handeyildirim/Analog-PCB-and-Schematic-Designing-Project/Ekran Alıntısı7.JPG

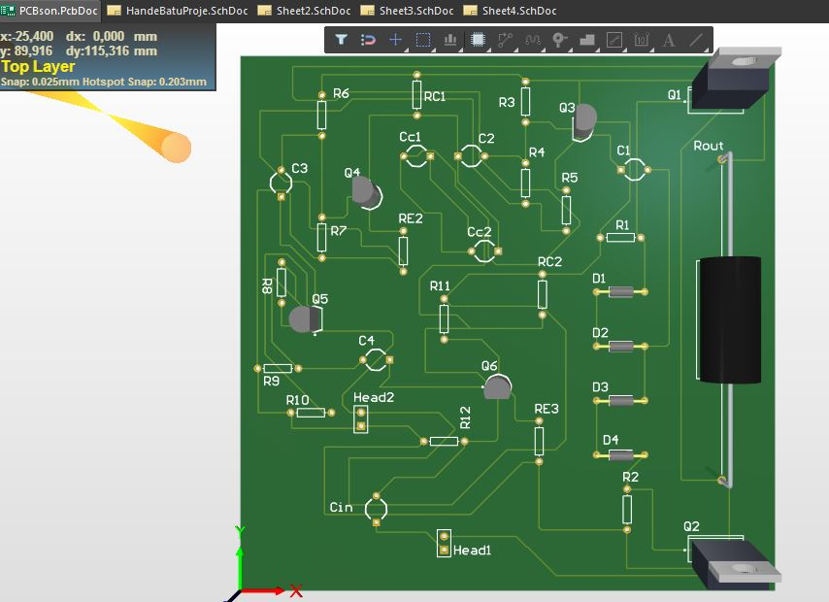
Ekran Alıntısı7.JPG
