handeyildirim/Analog-PCB-and-Schematic-Designing-Project/Ekran Alıntısı9.JPG

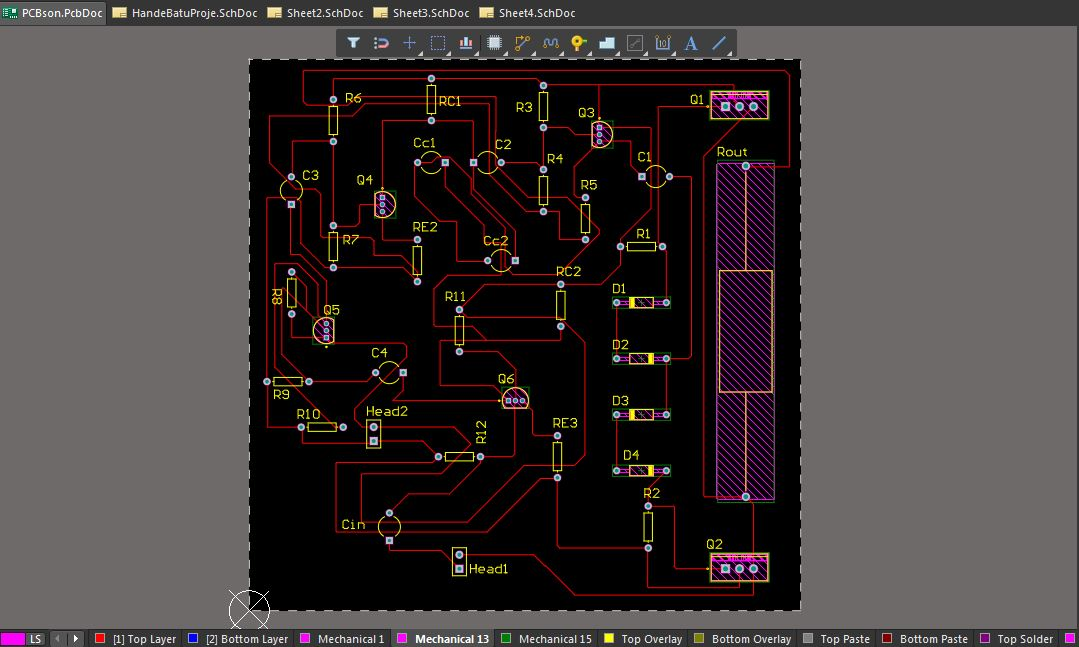
Ekran Alıntısı9.JPG
