handeyildirim/Analog-PCB-and-Schematic-Designing-Project/README.md

# Analog-PCB-and-Schematic-Designing-Project
To Design A 500 Voltage Gain And 20Hz-1MHz Threshold Frequency Range Speaker's Schematic and PCB
