handeyildirim/Analog-PCB-and-Schematic-Designing-Project/HandeYildirim_141201047_Rapor2.docx

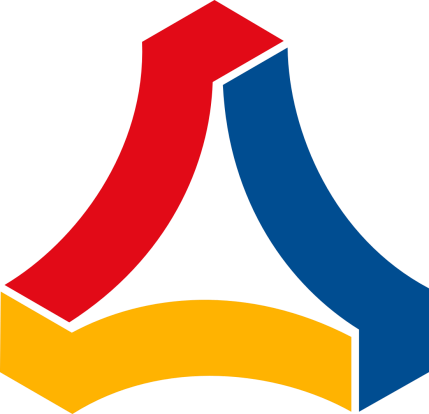
[picture p3: figure]

TOBB Ekonomi ve Teknoloji Üniversitesi

Elektrik – Elektronik Mühendisliği Bölümü

ELE311 – Analog Elektronik Devreler

## Proje Raporu - 2

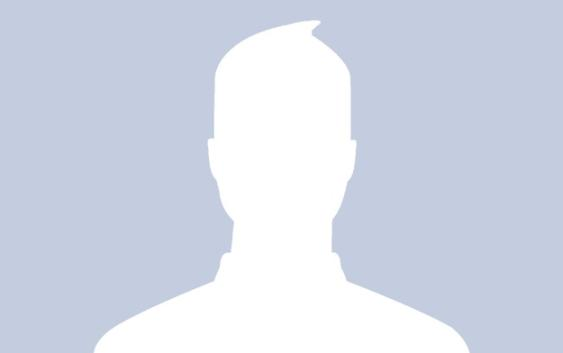
[picture p4: figure]

Adı Soyadı | Hande Yıldırım
Numara | 141201047
Tarih | 30.03.2020

1. GİRİŞ
  1.1. Projenin Amacı

Bu deneyde aşağıdaki özellikleri sağlayan bir yükseltici tasarlanması istenilmektedir:

a. Voltaj kazancı: 500

b. 8 Ω üzerine 5 W RMS güç verebilmek.

c. Eşik frekansları: 20 Hz – 1 MHz

Bu özellikleri sağlayan bir yükseltici çok katlı olacaktır. İlk rapor için 3 katman kullanılarak tasarım yapıldı, fakat daha sonrasında yapılan hesaplamalar sonucunda 4 katmanda daha iyi veriler elde edilerek tasarım yenilenmiştir.

  1.2. Projenin Faydaları

Bu proje yapılırken bir çok faydası olmuştur. Bunlar şu şekilde sıralanabilir:

- Altium, Eagle, Multisim, LT Spice gibi önemli tasarım programlarının kullanımı öğrenildi.
- Yükseltici analizlerinin yapımı anlaşıldı.
- Analog devreler ve çalışma mantıkları iyice öğrenildi.
2. PCB TASARIM SÜRECİ

Bu kısımda genel olarak PCB’nin tasarım süreci anlatılmıştır. PCB tasarımı yapmak için Altium programı kullanılmıştır. Sırasıyla yapılan işlemler şu şekildedirler:

1) Öncelikle simülasyon programında tasarlanmış olan devre Altium’da şematik olarak çizilmiştir. Bu yapılırken kullanılan her bir materyal Altium’un var olan kütüphanesinden olmayanlar da internetten kütüphaneleri indirilerek şematiğe eklenmişlerdir.
2) İndirme işlemi sonrası direnç, kapasitör, transistör gibi devre elemanları kolaylıkla devreye eklenmişlerdir ve aralarına line kullanılarak kablolama yapılmıştır.
3) Ayrıca her bir katman arasında rastgele delikler koyularak PCB basımı sonrası buraya kablolar lehimlenip her bir katmanın kolaylıkla ölçümünün yapılması sağlanmıştır.
4) AC ve DC kaynak girişleri için ise header kullanarak buralarda VCC, -VCC, GND, AC voltaj girişleri oluşturulmuşlardır.
5) Şematik çiziminde son olarak devre elemanlarının isimlendirmeleri tamamlanmıştır.
6) Şematik çizimi tamamlandıktan sonra PCB dosyası oluşturuldu ve PCB’nin ölçüleri şu şekilde ayarlandı:
i. PCB Boyutları: 10cm x 10cm
ii. Distance between conductors: 0.20mm
iii. Conductor width: 0.20mm
iv. Annular clearance PAD – Cu: 0.20mm
v. Copper PAD width: 0.80mm
vi. Drill width: 0.35mm
vii. VIA: 0.8mm – 0.9mm
7) Bu ayarlamalardan sonra şematikte yer alan devre PCB’ye aktarıldı.
8) PCB aktarımı sonrası devre karışık bir şekilde geldiğinden her bir malzemenin PCB üzerindeki konumları belirlendi.
9) Malzemelerin Hepsi PCB’nin Mechanical 13 katmanına yerleştirildi.
10) Sonrasında malzemeler arasındaki kabloların hiçbiri çakışmayacak şekilde tekrar kablolama büyük bir özenle yapıldı.
11) Daha sonra grup numaraları ve projeyi yapanların isimleri yazıldı.
12) En son devre bir kere daha hem 2D hem de 3D olacak şekilde kontrol edildi.
13) Kontroller bittikten sonra PCB’nin Bottom katmanına topraklama yapıldı ve PCB basımı için Gerber Dosyası oluşturuldu.

Tüm bu işlemlerin yapım aşamalarına göre şematiği Şekil 2.1’de ve en son elde edilmiş olan PCB’nin Şekil 2.2’deki gibi hem 2 boyutlu, hem de Şekil 2.3’teki gibi 3 boyutlu görselleri aşağıdaki gibidirler:

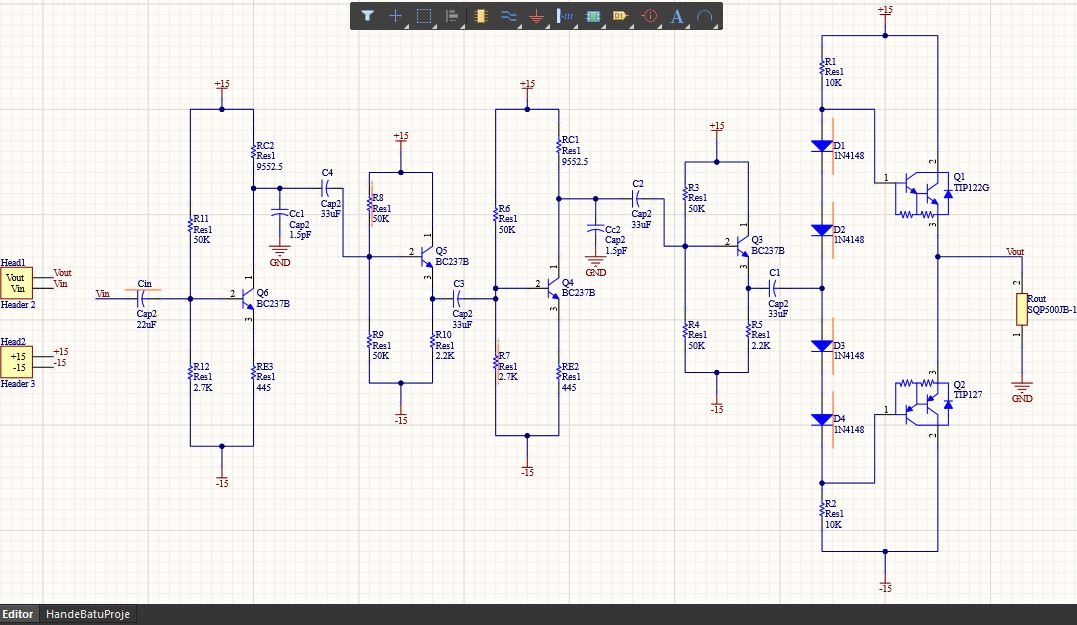
[picture p5: figure]

Şekil 2.1: Altium Programında Tüm Devrenin Şematiğinin Gösterimi

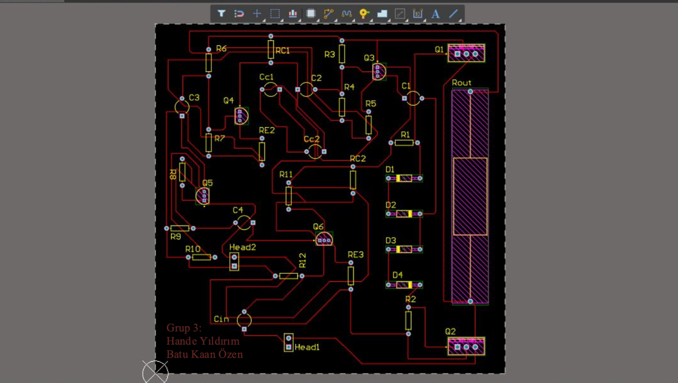
[picture p6: figure]

Şekil 2.1: Altium’da Şematikte Çizilmiş Olan Devrenin PCB’ye aktarılmış 2 Boyutlu Görüntüsü

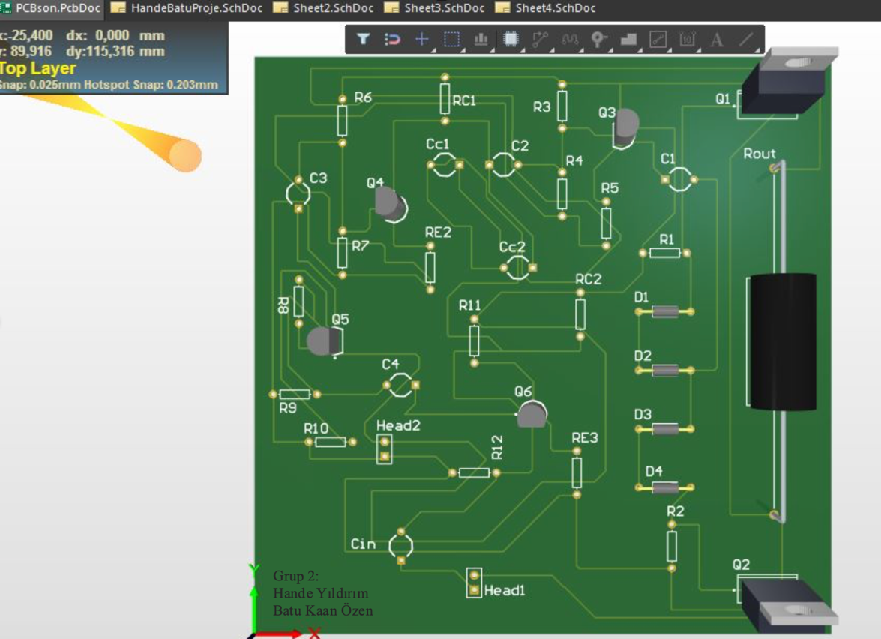
[picture p7: figure]

Şekil 2.1: Altium’da Şematikte Çizilmiş Olan Devrenin PCB’ye aktarılmış 3 Boyutlu Görüntüsü

3. YAPILAN DEĞİŞİKLİKLER

Devre tasarımının yapıldığı ilk günden beri pek çok değişiklik yaşanmıştır. Bu nedenle raporda anlatılan pek çok açıklama ve yapılan hesaplamalar 1. Rapor’dan oldukça farklıdır. Bunlara örnek vermek gerekirse:

1) Devre 3 kattan 5 kata çıkarıldı.
2) 1 Common Emitter devresi yerine, bu devreden 2 tane kullanıldı.
3) 1 Emitter Follower devresi yerine, bu devreden 2 adet kullanıldı.
4) 200 elde edilen kazanç yaklaşık olarak 500 kazanca çıkarıldı.
5) 2W RMS güç yerine 5W güç çekildi
6) Kullanılan malzeme sayısı artırıldı.
7) Son olarak, 30 MHz’lik bir yüksek frekans kesim noktası bulunmak istendi fakat tüm hesaplamalar ve simülasyon sonucunda bu kesim frekansının elde edilemediği anlaşıldı. Bunun sebebi olarak da, piyasada bulunabilen ve tasarlanan böyle bir devre için 30 MHz’lik kesimi sağlayabilecek bir kapasitörün ve transistörün bulunmamasıdır. Şu anki tasarlanmış olan devredeki bu malzemeler maksimum 6 MHz’lik bir kesim yapabiliyorlar. Bu nedenle devrenin yüksek kesim frekansı değiştirilmemiş ve 1 MHz olarak bırakılmıştır.

Tüm bu değişikliklerin daha iyi anlaşılabilmesin için aşağıda yapılan tüm teorik hesaplamalar, yorumlar ve sonuçlar detaylıca anlatılmışlardır. Yani şimdi her bir PCB katının tasarımlarına ve teorik olarak hesaplamalarına aşağıdaki gibi bakılacak olursa:

  3.1. Ortak Emetör Yükselticisi (Common Emitter Circuit)

Bu projede tasarlanan ilk katman “Common Emitter” yani ortak emetör yükselticisidir. Bu katmandaki asıl amaç projede istenilen kazancı elde etmektir. İlk rapordaki hesaplamalar 200 kazancına göre hesaplanmıştırlar. Fakat bu rapor 500 kazanca göre yazılmıştır ve tasarımda yine 500 kazanca göre yapılmıştır. Devreye zarar vermemek ve katman yükünü azaltmak amacıyla bu kazanç iki tane ayrı ortak emetör devresi kullanılarak (yani tüm devre de toplamda kullanılmış olan iki tane farklı ortak emetör devresinden elde edilen kazançların çarpılmasıyla) elde edilmiştir. Burada önemli bir nokta olarak, doğrudan 500 kazancı teorik olarak elde edip PCB üzerindeki devreyi de doğrudan bu değerlere göre kurunca elde edilen total kazanç gerçek hayatta PCB üzerine kurulduğunda amfi katından dolayı düşürülebileceğinden dolayı tasarım yapılırken toplam kazanç yaklaşık olarak 520 kazanca göre hesaplanmıştır.

Hesaplamalar yapılırken öncelikle devrelerin DC ve AC çözümleri yapılmıştır. Fakat öncelikle bilinmesin gereken bazı teorik bilgiler vardır. Küçük sinyal analizi ve Q-Point bu konulardandır ve aşağıdaki gibi açıklanmışlardır. Buna göre ortak emitör yükselticisinin küçük sinyal modeli aşağıdaki gibi Şekil 1.1’de verilmiştir:

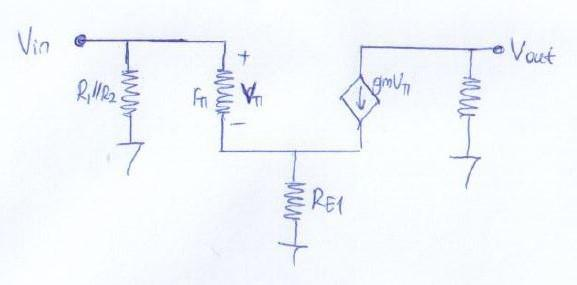
[picture p8: figure]

Şekil 1.1: Ortak emitör yükselticisinin küçük sinyal modeli

Bu modele göre çıkış ve giriş gerilimleri aşağıdaki Denklem 1.1 ve Denklem 1.2’de verildiği gibi hesaplanırlar:

V_(OUT) =-g_m *V_π *(R_C ∥R_L ) (1.1)

V_(IN) =V_π +g_m *V_π *R_(E1) (1.2)

Gerilim kazancı denklem 1.3’deki gibi birbirine oranıdır. gmRE >> 1 olduğundan gerekli sadeleştirmeler yapıldığında kazanç değeri bulunur. Hesaplamalardaki kazanç değeri toplamda 525 olarak kabul edildi. İlk ortak emetör katmanı 35, ikinci ortak emetör katmanı ise 15 olarak tercih edildi. 525 kazanç 500’den büyük olarak kasıtlı seçildi. Bunun sebebi devredeki bütün katlar birbirine bağlandıktan sonra bir miktar kazancın düşme riskinin olmasıydı.

En son denklemler düzenlendiğinde ise tek 1 ortak emetör katmanı için aşağıdaki kazanç denklemi elde edilir:

A_v =(V_(OUT))/(V_(IN))=(-g_m *V_π *(R_C ∥R_L ))/((V_π +g_m *V_π *R_(E1) )) (1.3a)

A_v =(-g_m *(R_C ∥R_L ))/(1+g_m *R_(E1)) (1.3b)

|A_v |≅(R_C ∥R_L)/(R_(E1)) (1.3c)

Kazancın yanı sıra Q-Point’e yani yükselticinin yük eğrisine bakılacak olursa:

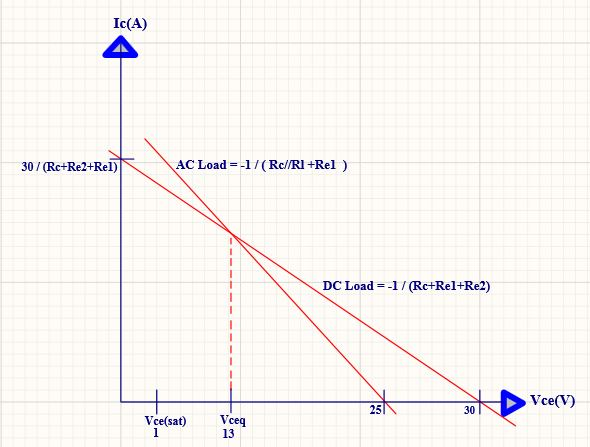
[picture p9: figure]

Şekil 1.2: Ortak emitör yükselticisinin yük eğrisi (Altium’da temsili olarak çizilmiştir.)

Ortak emitör yükselticisinin yük eğrileri yukarıdaki gibi şekil 1.2’de verilmiştir. VCC degeri VCE’ye bağlıdır. RE direncinin etkiside hesaba katılarak, VCE değerinin maksimum degerinden yüksek seçilmelidir. Bu nedenle 15V olarak seçilmiştir. Transistör doyuma girdiğinde akım kazancı düşeceğinden bir miktar pay bırakılmalıdır. Tasarımda bu pay 1V olarak alınmıştır.

Transistörün diğer DC kutuplama parametresi ICQ’yü belirlemek için yük üzerindeki akım salınımını hesaplamak gerekmektedir. Yük üzerindeki maksimum voltaj salınımı, denklem 1.4’de verildiği gibi maksimum akım salınımı ile yük direncinin çarpımına eşittir.

∆V_(OUT) =∆I_(OUT) *R_L (1.4)

Kolektör akımındaki toplam salınım, yükteki akım salınımı ile RC direncindeki akım salınımın toplamına eşittir. AC yük eğrisi incelendiğinde maksimum akım salınımı denklem 1.5’de verildiği gibi yaklaşık olarak (2*ICQ)’ya eşittir.

∆I_C =∆I_(R_C) +∆I_(OUT) ≅2*I_(CQ) (1.5)

2V_(CC) =V_(CEQ) +I_(CQ) *(R_C +R_(E1) +R_(E1) ) (1.6)

Bütün bu teorik bilgilerin yanı sıra devre hesaplamasında gerçekte öncelikle aşağıdaki gibi tek bir ortak emetör katı için kazanç hesaplaması yapılmıştır. Bu hesaplama sonrasında ise aynı katmandan devreye bir tane daha bağlanarak, yukarıda da söylendiği gibi, iki katmanın kazançları çarpılmıştır. Yani yine yukarıda söylendiği gibi yaklaşık 520 kazanç elde edilmiştir. Buna göre izlenilen yol şu şekildedir:

Öncelikle DC çözüm ile başlanır. Aşağıda temsili olarak çizilmiş olan şekil 1.3’teki devreye göre Thevenin eş değer direnci ve voltajı aşağıdaki eşitliklerdeki gibi hesaplanırlar:

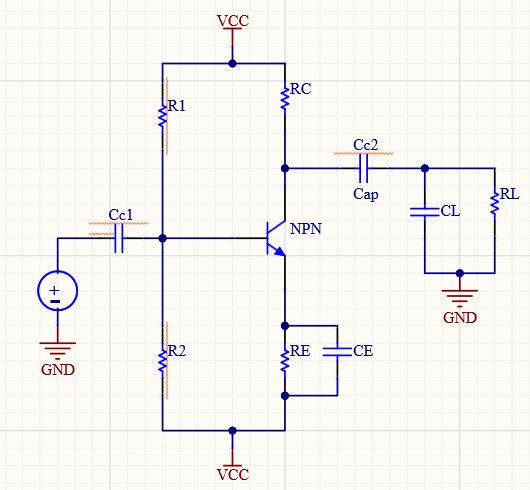
[picture p10: figure]

Şekil 1.3: Ortak emitör yükselticisi temsili devresi(Altium kullanarak çizilmiştir)

R_(TH) =(R_1 *R_2)/(R_1 +R_2) (1.7)

V_(TH) =2* V_(CC) *(R_2)/(R_1 +R_2)-V_(CC) =V_(CC) *(R_2 -R_1)/(R_1 +R_2) (1.8)

Daha sonra Kirchoff Voltaj Kanunu kullanılarak aşağıdaki denklemler elde edilirler:

-V_(CC) +(β+1)*I_B *R_E +V_(BE) +I_B *(R_1 *R_2)/(R_1 +R_2)-V_(CC) *(R_2 -R_1)/(R_1 +R_2)=0 (1.9)

Buradan da şu denklem elde edilir:

2*V_(CC) *(R_2)/(R_1 +R_2)-V_(BE) =I_B *((R_1 *R_2)/(R_1 +R_2)+(β+1)*R_E ) (1.9a)

Sonrasında R2’ye bağlı olarak R1 direncinin denklemi aşağıdaki denklemler çözülerek elde edilir:

(2*V_(CC) *R_2 -I_B *R_1 *R_2)/(R_1 +R_2)=I_B *(β+1)*R_E +V_(BE) (1.9b)

[I_B (β+1)R_E +V_(BE) -2V_(CC) ]*R_2 +[I_B (β+1)R_E +V_(BE) ]*R_1 =-I_B R_1 R_2 (1.9c)

Bu denklem düzenlenirse sonuç olarak aşağıdaki eşitlik elde edilir:

R_1 =(2V_(CC) -V_(BE) -I_B *(β+1)*R_E)/(I_B *R_2 +I_B *(β+1)*R_E +V_(BE))*R_2 (1.9d)

Yani rastgele verilecek olan bir R2 direnç değerine göre bu denklem kullanılarak R1 direnç değeri elde edilebilir.

Bundan sonrasında ise yazılan başka bir Kirchoff denkleminden:

-V_(CC) +(β+1)*I_B *R_E +V_(CE) +β*I_B *R_C =V_(CC) (1.10a)

Böylece RE direnci çekilirse:

R_E =((2*V_(CC) -V_(CE) -β*I_B *R_C ))/((β+1)*I_B) (1.10b)

Tasarım yapılırken transistör olarak BC238B kullanılmıştır ve bu transistörün ß değeri datasheetine bakılarak 290, VCE değeri 5V, VBE değeri 0.62V ve IC değeri de 2 mA olarak alınmıştır. Bu durumda IB ise şu şekilde bulunur:

I_B =(I_C)/β≅7μA (1.11)

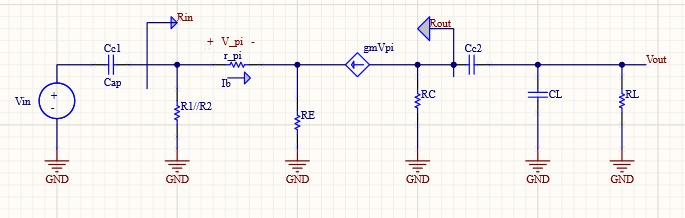
[picture p11: figure]

Şekil 1.4: Ortak emitör yükselticisi devresinin küçük sinyal eş değer devresi (Altiumda çizilmiştir.)

Daha sonra AC çözüm yapılır. Burada öncelikle küçük sinyal analizi yapılır. Bunun sonunca Rin değeri aşağıdaki denklemler kullanılarak şu şekilde bulunur:

V_(TH) =(β+1)*I_B *R_E (1.17)

I_(TH) =I_B (1.18)

R_(TH) =(β+1)*R_E (1.19)

R_(in) =R_1 ∥R_2 ∥(r_π +(β+1)*R_E ) (1.20)

Rout değeri ise aşağıdaki denklemler kullanılarak şu şekilde bulunur:

V_(TH) =-(β)*I_B *R_C (1.21)

I_(TH) =-β*I_B (1.22)

Voltajın akıma bölünmesi sonucu direnç şu şekilde bulunur:

R_(TH) =(V_(TH))/(I_(TH))=R_C (1.23)

Sonuç olarak:

R_(out) =R_C ∥R_L (1.24)

Kazancı bulabilmek için ise aşağıdaki denklemler kullanılırlar:

V_(in) =I_b *(r_π +(β+1)*R_E ) (1.25)

V_(out) =-I_b *β*(R_C ∥R_L ) (1.26)

Denklem 1.25 ve 1.26’nın birbirine bölünmesi sonucu:

|A_V |=|(V_(out))/(V_(in))|=(β*(R_C ∥R_L ))/(r_π +(B+1)*R_(E1)) (1.27)

AC analizdeki tüm bu hesaplamaları yapabilmek için öncelikle aşağıdaki değerlerin de bilinmesi gerekir:

g_m =(I_(CQ))/(V_T)=(2.0 mA)/(26 mV)≅76.92 S (1.28)

r_π =(V_T)/(I_(BQ))=(26 mV)/(18*10^(-6) A)≅1430 kΩ (1.29)

Buraya kadar bütün formüller çıkarıldıktan sonra ilk olarak kazancın 520 olması durumuna göre bazı hesaplamalar yapıldı. Bazı değerler varsayılarak diğer bilinmeyenler bulundular. Yani en başta;

VCC = 15V, (1.30)

R2 = 2000Ω, (1.31)

VT = 26mV, (1.32)

IC = 2mA ve buna bağlı olarak IB = 0.018mA, (1.33)

ß = 290, (1.34)

rπ = 1430 kΩ, (1.35)

VCE = 5V, (1.36)

VBE = 0.62V, (1.37)

RC = 12100Ω, (1.38)

RL = 47 kΩ (1.39)

değerleri varsayılarak sırasıyla aşağıdaki denklemler hesaplanmıştır:

1. Denklem 1.15’ten RE = 398 Ω gelir.
2. Denklem 1.27’den kazanç AV = 23.3(tek katman için bulunan kazanç) elde edilir. Bu kazancın elde edildiği katmandan 2 tane kullanılırsa kazanç:

AV = 23.3 * 23.3 = 5 (1.40)

olarak bulunur.

3. Son olarak denklem 1.13’den tek bilinmeyen olan R1 = 39 kΩ olarak bulunur.

Geriye bilinmeyen olarak devrede sadece kapasitör değerleri kalmıştır. Bu değerleri de bulabilmek için frekanstan faydalanılır. Bu projedeki kesim noktaları küçük frekans için 20Hz büyük frekans için 30 MHz olması istenmiştir. Devrenin düşük kesim frekansını CC1 kapasitörü doğrudan etkilerken büyük kesim frekansını ise C kapasitörü etkilemektedir. Bu değerleri teorik olarak bulabilmek için öncelikle frekans denklemi yazılır ve buradan her bir kapasitörü etkileyen direnç değerleri belirlenir. Buna göre en son bilinmeyenler bulunur.

Frekans denklemi bilindiği üzere aşağıdaki şekildedir:

f=1/(2πτ) (1.41)

Bu denklemden her bir kapasitörün teorik olarak hesaplanması şu şekildedir:

C1 kapasitörü için:

2πf=1/(C_1 cR_1 //R_2 //(r_π +(β+1)R_E )]) (1.42a)

C_1 =1/(2π*5*12.3k)=0.85μF (1.42b)

C2 kapasitörü için:

2πf=1/(C_2 (R_C +R_L )) (1.43a)

C_2 =1/(2π.10*35k)=100μF (1.43b)

CE kapasitörü için:

2πf=1/(C_E [((R_1 //R_2 +r_π)/β+R_(E1) )//R_(E2) ]) (1.44a)

C_E =1/(2π.10.0.1k)=160μF (1.44b)

CL kapasitörü için (Burada önemli bir detay olarak şunun bilinmesi gerekir: Yüksek eşik frekansı 30 MHz olması için Load kapasitörü bağlanmalıdır.) :

2πf=1/(C_L *R_(OUT)) (1.45a)

C_L =1/(2π20.10^3 .5.07k)=0.47uF (1.45b)

Tüm bu hesaplamalar sonrasında NI Multisim programı kullanılarak aşağıdaki gibi Common Emitter Devresi tasarlanmıştır. Bu tasarım yapılırken gerçek olan direnç ve kapasitör değerlerini kullanmaya çok dikkat edilmiştir. BOM Listesinde de görülebileceği devre için kullanılabilecek olan tüm dirençler reel değerlere sahiptirler. Bunun yanı sıra devrede bazı dirençler (12100 Ω gibi) doğrudan satılmamaktadır. Bunun için başta bu değeri 12kΩ’a yuvarlayarak yeniden hesaplamalar yapılmıştır. Fakat bunun sonucunda devre satürasyona girmiştir ve ne yazık ki istenilen kazanç elde edilememiştir. Bu nedenle bu değeri yuvarlamak yerine 12kΩ’luk bir direnç ile 100Ω’luk bir direnç birbirlerine seri bağlanarak bu problem çözülmüştür ve istenilen sonuç rahatlıkla elde edilebilmiştir.

Hesaplamalar ve kullanılabilecek malzeme listesi yukarıdaki gibi kesinleştirildikten sonra aşağıdaki gibi devre tasarlanmış ve giriş-çıkış voltajları hesaplanarak kazanç elde edilmiştir. Aşağıda tasarlanmış olan devreler ve bunların satürasyona girmediklerini gösteren grafikler verilmiştir. Bunun yanı sıra düşük kesim frekansı olan 20Hz, Cin sayesinde hesaplanabildiğinden dolayı aşağıda düşük kesim frekansını gösteren grafikte yer almaktadır. Yüksek kesim frekansını ve her iki kesim frekansını gösteren grafik ise sonraki aşamalarda açıklanmıştır.

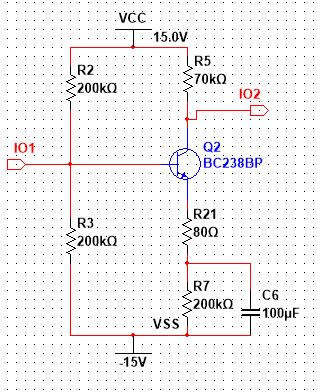
[picture p12: figure]

Şekil 1.4: Multisim yardımıyla bu projede kullabılmak içintasarlanmış olan Common Emitter Devresi 1

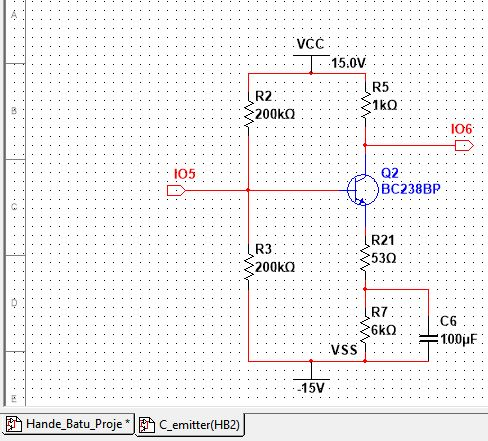
[picture p13: figure]

Şekil 1.4: Multisim yardımıyla bu projede kullabılmak içintasarlanmış olan Common Emitter Devresi 2

  3.2. Ortak Kolektör (Emetör Takipçisi) Tasarımı

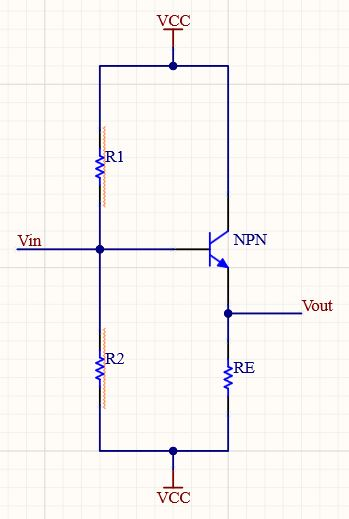
[picture p14: figure]

Şekil 3.2.1: Ortak Kollektör Devresi (Temsili olarak Altium kullanılarak çizilmiştir.)

Yukarıdaki gibi temsili bulunan bir emetör takipçisi devresinin küçük sinyal modeli ise aşağıdaki gibidir:

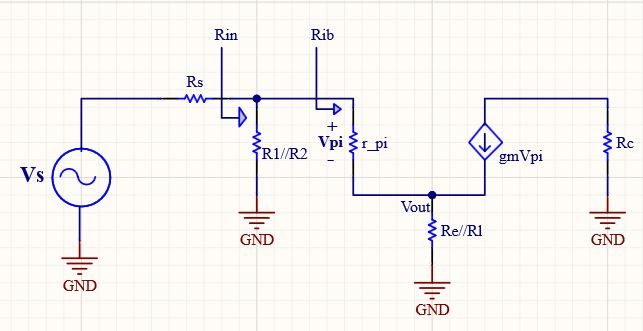
[picture p15: figure]

Şekil 3.2.2: Emitör Takipçisinin Küçük Sinyal Modeli

Bu iki çizimden yola çıkarak bazı denklemler aşağıdaki gibi yazılıp devrenin teorik hesaplamaları da yapılabilir:

V_(OUT) =I_B *(β+1)*(R_E ∥R_L ) (2.1)

V_(IN) =I_B *(r_π +(β+1)*(R_E ∥R_L )) (2.2)

V_(IN) =(V_s * R_(IN))/(R_(IN) +R_S) (2.3)

Bu denklemler göz önüne alındıklarında devrenin gerilim kazancının aşağıdaki denklem 2.4a’daki gibi olması beklenmektedir:

A_V =(V_(OUT))/(V_(IN))=(I_B *(β+1)*(R_E ∥R_L ))/(I_B *(r_π +(β+1)*(R_E ∥R_L )))*(R_(IN))/(R_(IN) +R_S) (2.4a)

Burada ilk ifade yaklaşık olarak 1’e eşit olduğundan kazanç aşağıdaki denklem 2.4b’deki formuna dönüşür:

A_V =(R_(IN))/(R_(IN) +R_S) ≅1 (2.4b)

Teorik olarak kazanç 1 olarak bulunur. Bunun sebebi, RS değerinin RIN değerine çok küçük olmasıdır. Teorik olarak elde edilen bu kazanç ile devrede kullanılan gerçek değerlere göre elde edilen kazanç değeri birbirine çok yakındır. Bu durum aşağıda yer alan “Ölçüm Sonuçları” kısmında da yer almaktadır.

Daha sonra ilk bölüme benzer şekilde denklem 2.5‘te verildiği gibi çıkıştaki akım salınımı hesaplanır. Uygun RE değeri seçilerek, aşağıda bulunan denklem 2.6‘ya göre IEQ akımı bulunur. Seçilen VCEQ gerilimi ve IEQ akımına göre de denklem 2.7 kullanılarak DC kutuplamanın mümkün olup olmadığına bakılır ve sonrasında RC değeri tayin edilir. En son olarakta, bias stable koşuluna göre denklem 2.8 ve denklem 2.9 kullanılıp R1 ve R2 dirençleri hesaplanmış olunur.

∆V_(OUT) = ∆I_(OUT) *R_L (2.5)

∆I_E = ∆I_(R_E) +∆_(I_(OUT)) ≅2*I_E (2.6)

2*V_(CC) = V_(CE) +I_E *(R_C +R_E ) (2.7)

R_(TH) =R_1 ∥R_2 =0.1*(β+1)*R_E (2.8)

Kirchoff’tan:

V_(TH) -2*V_(CC) =I_B *R_(TH) +V_(BE) +I_E *R_E (2.9)

Teorik olarak elde edilen tüm bu denklemlerin, devrede kullanılan direnç değerlerine göre hesaplamalarının yapımı sırasında VCC değeri 15V olarak ve RE değeri’de 2k şeklinde varsayılmıştır. Ayrıca daha sonrasında bu emetör takipçisi devreleri, bağlı oldukları devrelerinin (common emitter devrelerinin) ROUT değerlerini kendi RIN değerleri ile karşıladıklarından buna göre R1 ve R2 değerleri bulunur. Yani aslında common emitter devrelerinin ROUT’u, emitter followerların RTH (= R1 // R2) değerine eşit olacak şekilde bulunur.

Daha sonra köşe frekansları 20 Hz’i ayarlayacak şekilde C1 ve C2 kapasitör değerleri hesaplanmıştır:

C1 kapasitörü için:

2πf>1/(C_1 [R_S +(R_1 ∥R_2 ∥(r_π +(β+1)R_(E)) )]) (2.10a)

C_1 >1/(2π*)= (2.10b)

olarak bulunur.

C2 kapasitörü için:

2πf>1/(C_2 * [R_L +R_E ∥((β+1)*( r_π +R_1 ∥R_2 ∥R_S ))]) (2.11a)

C_2 >1/(2π*)= (2.11b)

olarak bulunur.

Sonrasında da yüksek eşik frekansının 1 MHz olması için de bir adet load kapasitörü bağlanmalıdır. Bunun değeri ise denklem 2.12a ve denklem 2.12b’de gösterildiği şekildedir:

2πf=1/(C_L *[R_L ∥C_2 *[R_L +R_E ∥[(β+1)*(r_π +R_1 ∥R_2 ∥R_s )]]]) (2.12a)

C_L =1/(2π40.10^3 *19)= (2.12b)

olarak bulunur.

Emetör takipçisi devresinden tüm devre içerisinde 2 adet kullanılmıştır. Her bir common emetör devresinden sonra 1 adet emetör takipçisi koyulmuştur. Bunun sebebini açıklamak gerekirse:

- Başta iki adet common emetör devresi peş peşe koyulmul ve sonrasında 1 adet emetör takipçisi koyulmuştur. Bu durumda tüm devre doğrudan satürasyona girmiştir. 2 adet koyulduğunda ise devre satürasyondan çıkmıştır ve beklenilen sonuç alınmıştır.
- Ayrıca iki ortak emetör devresi arasında yer alan emetör takipçisi devresi bir nevi “buffer” görevi yapmaktadır. Yani daha anlaşılır bir şekilde söylemek gerekirse kendinden önce devrenin ROUT’unun ve kendinden sonraki devreninde RIN’inin yok sayılmasını ve böylece devrenin satürasyona girmesini ve yanmasını önlemiş olur. Bu şekilde teorik hesaplamaları yapmak daha da kolaylaşır ve kazanç çok daha rahat bir şekilde elde edilirken daha güvenli olan bir devre de tasarlanmış olur.

Bu hesaplamalar ve bilgiler doğrultusunda tasarlanmış olan emetör takipçisi devreleri şu şekildedirler (İki devre de aynıdır.):

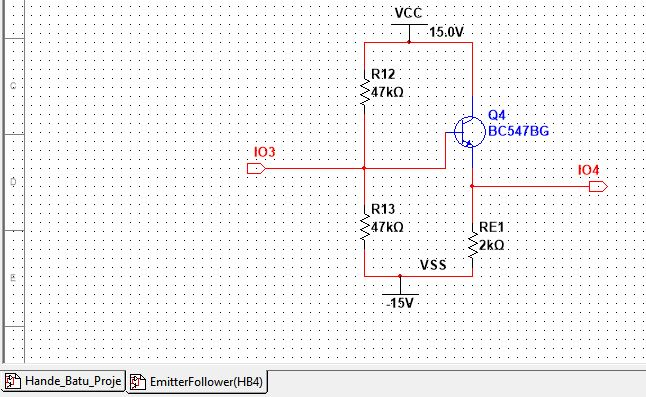
[picture p16: figure]

Şekil 3.2.3: Tasarımda Kullanılmış Olan Emitör Takipçisi Devresi

Bu devrelerden elde edilen kazançlara, frekans cevaplarına ve bunların grafiksel olarak gösterimlerine “Ölçüm Sonuçları” kısmında ulaşılabilinir.

  3.3. Güç Yükselticisi Katmanı

Bu katmanda ise daha verimli olabilmesi ve devreden akım çekebilmek için Darlington Amplifier kullanılmıştır. Yani burada Darlington transistörli amfi kullanıldı. Devrenin şeması ve teorik hesaplamaları ise aşağıda gösterildiği gibidir:

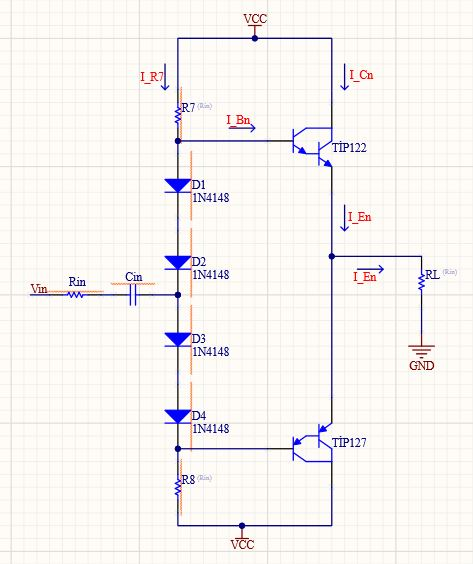
[picture p17: figure]

Şekil 3.3.1: Altium Programında Temsili Olarak Çizilen Bir Darlington Yükselticisi Devresi

Burada öncelikle DC analiz yardımıyla, projede de istenildiği üzere 8 Ω direnç değeri için 5W RMS güç çıkışı verebilecek olan VOUT değeri buna bağlı olarakta geçen yük akımı hesaplanmalıdır. Buna göre:

P=5√2=1/2*(V_(OUT) ^2)/(R_L)=1/2*(V_(OUT) ^2)/8 (3.1)

Buradan;

V_(OUT) =10.6V (3.2)

olarak bulunur. Buradan da:

I_L =(V_(OUT))/(R_L)=10.6/8=1.32 A şeklindedir. (3.3)

Daha sonra üstteki transistörün açık ve alttakinin kapalı olma durumunu düşünerek, Kirchoff Gerilim Yasasına göre:

V_(IN) +2V_D -V_(BE(on)) -V_(OUT) =0 (3.4a)

Burada diyot voltajları, 1N4148 diyotlarının datasheetlerine bakılarak 1V oldukları görülmüş olur. Ayrıca transistör olarakta üstte TİP122 ve altta TİP127 transistörleri kullanılmıştır. Şu an için üst tarafın açık olduğu varsayılarak hesaplama yapıldığından dolayı TİP122 için VBE(on) voltaj değerlerini bilmek yeterlidir ve bu değer datasheete göre 2.5 Volt’tur. Buna göre denklem çözülürse:

V_(IN) +2*1-2.5-10.6=0 (3.4b)

V_(IN) =11.1 V olarak bulunur. (3.4c)

Daha sonrasında ise bilinmeyen direnç değerlerini bulabilmek amacıyla öncelikle bilinmeyen akımlar bulunur ve daha sonra da Kirchoff kullanılarak direnç değerleri bulunur. Burada alttaki ve üstteki direnç değerlerinin hemen hemen birbirlerine eşit değerler oldukları bilindiğinden dolayı sadece 1 tanesine göre hesaplama yapıp onu bulmak yeterlidir. Burada transistörlerin ß değeri datasheetlerine göre 1000 olarak alınmıştır. Tüm bunların hesaplanması da aşağıdaki gibidir:

I_L =I_(En) =1.32 A (3.5)

Buradan:

I_(Bn) =(I_(En))/(β+1)=(1.3A)/(1000+1)≅1.32mA (3.6)

I_(R7) =I_L +I_(Bn) =1.32+1.32≅1.34mA (3.7)

Daha sonrasında bir tane daha Kirchoff voltaj denklemi yazarak bilinmeyen R7 direnç değeri kolayca bulunabilir.

V_(CC) -I_(R7) *R_7 -V_(BE(on)) -R_L *I_L =0 (3.8a)

Buradan:

15-1.34*10^(-3) *R_7 -2.5-10.6=0 (3.8b)

R_7 =1.41 kΩ (3.8c)

Girişteki salınım voltajını hesaplayabilmek için öncelikle kazancın bulunması gerekmektedir, kazancı bulduktan sonra kazanç formülünde çıkış salınım voltajını ve kazanç değeribilindiğinden girişteki salınım voltajı da hesaplanabilir. Bunun nedenle AC analiz yapılarak aşağıdaki gibi öncelikle kazanç bulunur.

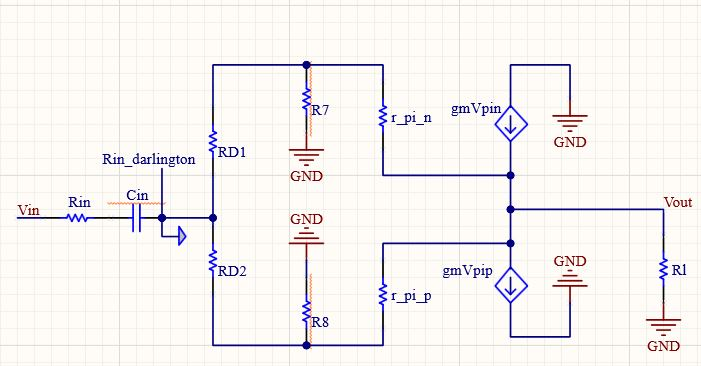
[picture p18: figure]

Şekil 3.3.2: Altium Programında Temsili Olarak Çizilen Bir Darlington Yükselticisi Devresinin AC Analizi

Yukarıdaki gibi devrenin küçük sinyal analizi çizildikten sonra kazanç:

A_V =(V_(OUT))/(V_(IN))=10.6/11.1≅0.95 (3.9)

Buradan da görüldüğü gibi amfi katının kazancı beklediğimiz gibi yaklaşık olarak 1 geldi. Zaten tüm devrede genel olarak kazancı ayarlayan katlar ortak emetör katmanlarıdır. Bu neden yükseltici katının kazanca bir etkisi olmamalıdır. Elde etmiş olduğumuz teorik veriyle de bu kanıtlanmış oldu.

Kazançtan sonra AC analize devam edilirse:

R_(in_darlington) =R_(in_üst_darligton) ∥R_(in_alt_darlington) (3.10)

Bunu hesaplamadan önce küçük sinyal parametreleri bulunur:

r_(πn) =((β+1)*V_T)/(I_E) (3.11a)

r_(πn) =((1000+1)*0.026V)/1.3≅22.3Ω (3.11b)

Sonrasında küçük sinyal analizindeki diyot direnci için:

R_D =(V_F)/(I_F) (3.12a)

Burada VF ve IF(diyot direnci için gerekli olan ileri akım) değerleri devrede diyot olarak da 1N4148 modelinin datasheetine bakılarak bulunurlar ve buradan da RD şu şekildedir:

R_D =(1V)/(10mA)=100Ω (3.12b)

Şimdi kolaylıkla AC analiz çözümüne devam edilebilir:

R_(in_üst_darlington) =2*R_D +[R_7 ∥(r_(πn) +(R_E +R_L)/(β+1))] (3.13a)

R_(in_üst_darlington) =2*100+[1.46∥(22.3+8/(1000+1))] (3.13b)

R_(in_üst_darlington) =200+[1.46∥22.3] (3.13c)

R_(in_üst_darlington) =201.4 Ω (3.13d)

olarak bulunur.

Küçük sinyal analizindeki alt ve üst devreler eşdeğer olduğundan:

R_(in_alt_darlington) =R_(in_üst_darlington) =201.4 Ω (3.14)

Sonuç olarak ise Denklem 3.10’dan faydalanarak:

R_(in_darlington) =201.4 Ω∥ 201.4 Ω (3.15a)

R_(in_darlington) =(201.4 Ω * 201.4 Ω)/(201.4 Ω + 201.4 Ω)=100.7Ω (3.15b)

olarak bulunur.

Yapılan hesaplamaların ardından Multisim üzerinde devre kurulmuştur. Elde edilen bu değerlere göre, tüm devrenin en son katı olan yükseltici katı tasarlanmıştır. Tasarlanan bu kat şu şekildedir:

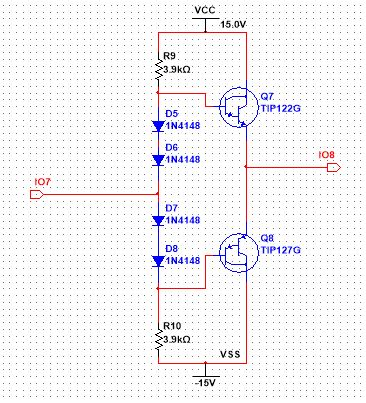
[picture p19: figure]

Şekil 3.3.3: Tasarlanan Devrede Kullanılan Darlington Yükselticisi Devresi

Geriye bilinmeyen değerler olarak sadece kapasitör değerleri kalmıştır. Bu değerler için ise devre üzerinde ciddi hasar veya değişikliklere sebep olmaması beklenir. O yüzden sahip olmaları gereken değerlere yaklaşık değerler verilerek elde edilecek olan frekans grafiğinin daha düzgün olması ve devrenin satürasyona girmemesi sağlanmıştır. Yani bazı kapasitör değerleri simülasyon sonuçlarına göre tasarım üzerinde yeni değerler deneyerek bilgisayar aracılığıyla bulunmuşlardır.

Sonuç olarak Multisim üzerine çizili olan yükseltici katmanı devresinin elde edilen simülasyon sonucu aşağıda “Ölçüm Sonuçları” kısmında yer almıştır. Bunun yanı sıra 5 katmanın bulunduğu devre ve bu devrenin frekans cevabı ve osiloskop ile gözlemlenmiş olan kazanç simülasyonu ve sonuçları da yine “Ölçüm Sonuçları” kısmında bulunmaktadırlar.

4. ÖLÇÜM SONUÇLARI

Tasarım aşaması yapılırken her bir katman bitirildiğinde sahip olmaları gereken kazanç miktarları ve frekans cevapları osiloskop ve simülasyon programı yardımıyla ölçülmüşlerdir. Bazı durumlarda teorik olarak hesaplanan değerler beklenen kazanç veya frekans aralıklarını karşılamamıştırlar. Bu durumda simülasyon programı üzerindeki devre değerleri elle rastgele değiştirilerek maksimum hata payı en aza indirilmeye çalışılmıştır. Elle elde edilen bu değerler daha sonra gerçek değerler olup olmadıkları araştırılarak gerçek olanlar BOM Listesi’ne eklenmiş, gerçek olmayanlar da kendisine en yakın olan gerçek değere dönüştürülerek simülasyon tekrarlanmıştır. En son değişiklikler yapıldıktan sonra projenin amacına uygun olarak tasarım tamamlanmıştır.

Aşağıda her bir katmanın ve daha sonrasında tüm devrenin ölçüm sonuçları ve bunlara bağlı yorumlar bulunmaktadır. Osiloskopla yapılan simülasyonda Channel B devrenin çıkış voltajını, Channel A ise devrenin giriş voltajını vermektedir.

  4.1. Common Emitter 1 (1. Katman):

Bu katman kazancın elde edildiği katmanlardan bir tanesidir. Aşağıda bu tasarlanan devre de kullanılmış olan ilk katmanın görseli yer almaktadır.

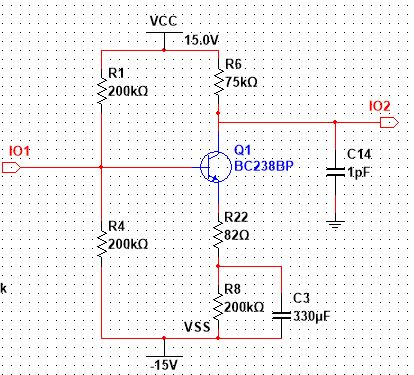
[picture p20: figure]

Şekil 4.1.1: Tasarlanan Devrede Kullanılan İlk Katman Olan Ortak Emetörlü Devre

Bu devrenin kazancını bulabilmek için osiloskop kullanılmıştır. Bunu gösteren simülasyon aşağıdaki şekildedir:

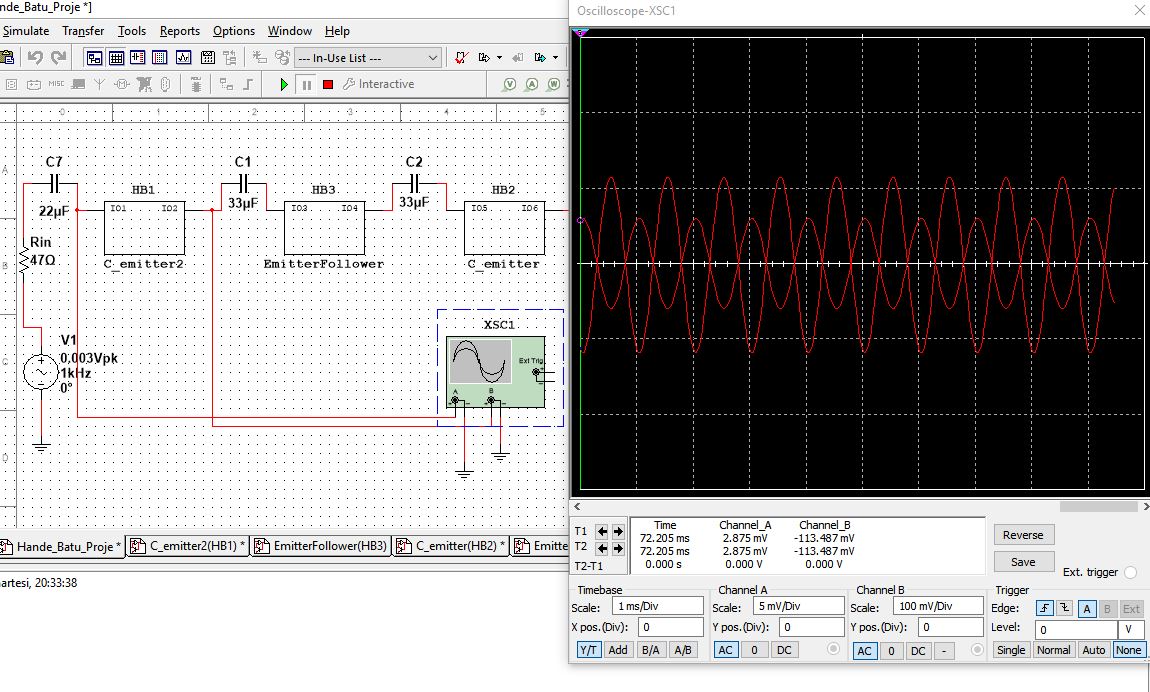
[picture p21: figure]

Şekil 4.1.2: İlk Katman Olan Ortak Emetörlü Devrenin Kazanç Simülasyonu

Osiloskop sonuçlarına bağlı olarak bu katmanın kazancı beklenildiği gibi şu şekildedir:

|A_V |=(113.487mV)/(2.875mV)≅39.4

  4.2. Emitter Follower 1 (2. Katman):

İkinci katmanda kullanılmış olan emetör takipçisi devresi, iki ortak emetör devresin arasında “buffer” görevi üstlenir ve devrenin kazancına hiçbir etkisinin olmaması yani kazancının 1 olması beklenir. Bunu sağlayan emetör takipçisi devresi ise bu tasarımda şu şekildedir:

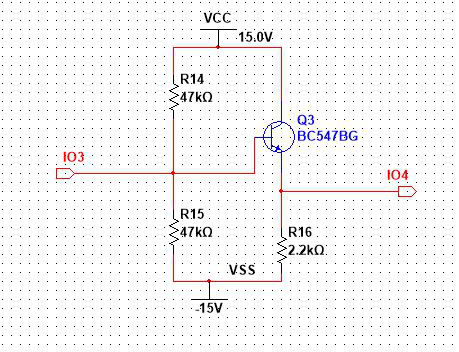
[picture p22: figure]

Şekil 4.2.1: Tasarlanan Devrede Kullanılan İkinci Katman Olan Emetör Takipçisi Devresi

Bu durumda kazancını gösteren simülasyon sonucu aşağıdaki gibi olmalıdır:

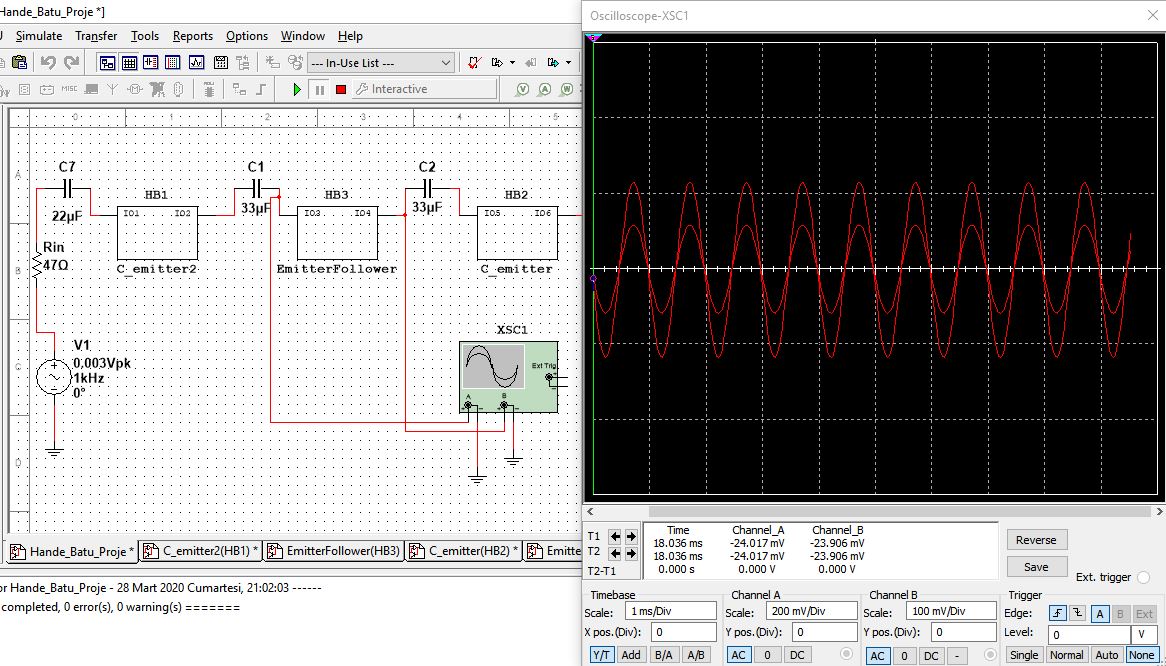
[picture p23: figure]

Şekil 4.2.1: İkinci Katman Olan Emetör Takipçisi Devresinin Kazanç Simülasyonu

Bu durumda simülasyon verilerine göre kazanç hesaplanacak olursa:

|A_V |=(23.906mV)/(24.017mV)≅0.99

Beklenildiği gibi kazanç değeri 0.99 yani yaklaşık olarak 1 çıkmıştır ve tüm devrenin kazancını etkilememiştir. Böylece bu katman rahatlıkla buffer görevini yapmaya devam edebilir.

  4.3. Common Emitter 2 (3. Katman):

Bu katman da yine 1. katman gibi kazancın elde edildiği diğer bir katmandır. Fakat bu katmanın kazancı birinci ortak emetör katmanına göre daha azdır. Aslında başta bu iki katmanın kazancı eşit olarak alınarak hesaplama yapılmıştır. Fakat bu durumda ikinci ortak emetör katmanına çekilen akım miktarı çok arttığından ve devre buna bağlı olarak voltaj üretemediğinden bu katman satürasyona girmiştir. Bunun çözüm olarak da ilk kazanç katmanının ikinci kazanç katmanına göre daha yüksek değere sahip olması sağlanarak devre satürasyondan çıkarılmıştır ve beklenen kazanç elde edilmiştir. Aşağıda bu tasarlanan devre de kullanılmış olan ilk katmanın görseli Şekil 4.3.1’de yer almaktadır:

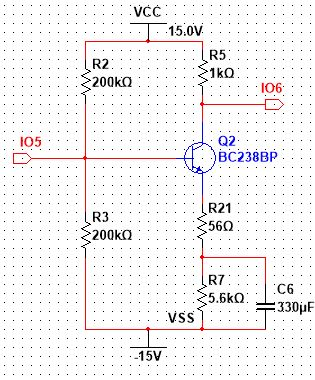
[picture p24: figure]

Şekil 4.3.1: Tasarlanan Devrede Kullanılan Üçüncü Katman Olan İkinci Ortak Emetörlü Devre

Devrenin giriş ucuna (IO5) bir voltaj kaynağı bağlanıp osiloskop yardımıyla simülasyonu gözlemlenirse elde edilen grafik ve voltaj kazancı aşağıdaki şekilde çıkmaktadır:

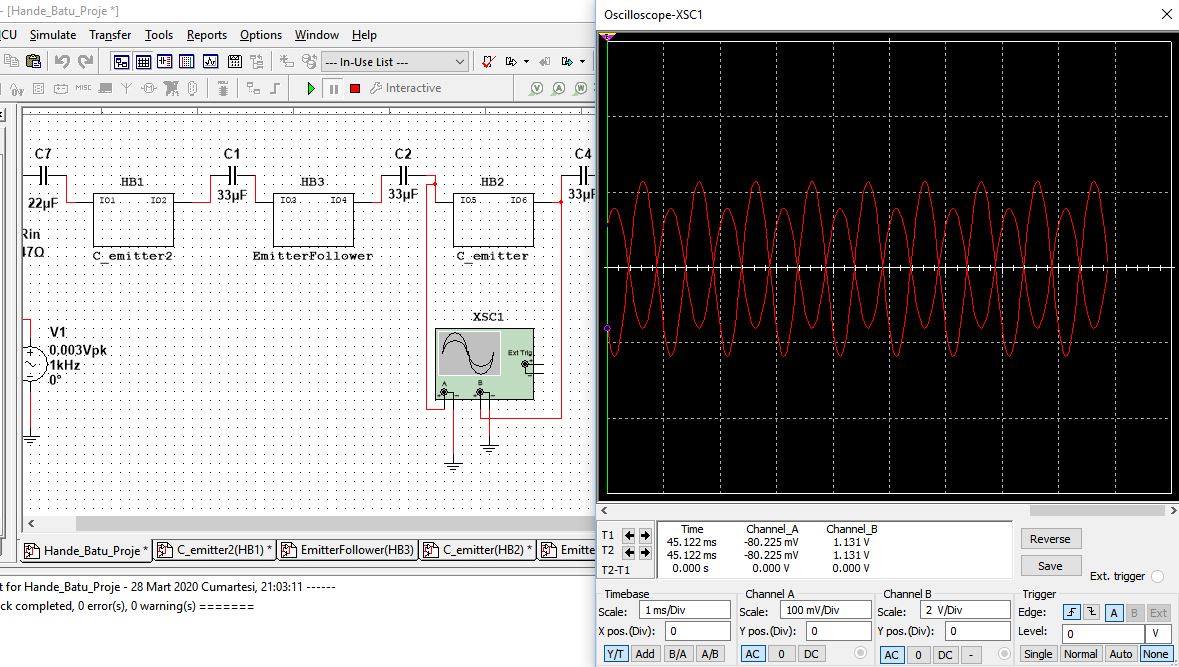
[picture p25: figure]

Şekil 4.3.2: Üçüncü Katman Olan İkinci Ortak Emetörlü Devrenin Kazanç Simülasyonu

Buna göre kazanç:

|A_V |=(1.131V)/(80.225mV)≅14

  4.4. Emitter Follower 2 (4. Katman):

İkinci emetör katmanı olan bu katman yine buffer görevi görerek yüksek değerler direnç ve akım girdilerinin bir sonraki katmana taşınmasını engeller. Yani bu katmanda 2. katman gibi RIN ve ROUT’ların devre çözümünde ortadan kalkmasına yardımcı olmuş olur. Aşağıda bu tasarım için kullanılan 4. katman (yani 2. katmanın aynısından bir tane daha) gösterilmektedir:

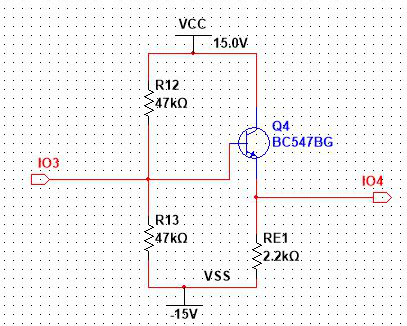
[picture p26: figure]

Şekil 4.4.1: Tasarlanan Devrede Kullanılan Dördüncü Katman Olan İkinci Emetör Takipçisi Devresi

Bu devrenin osiloskop yardımıyla simülasyonu yapılarak katman kazancına bakılacak olunursa:

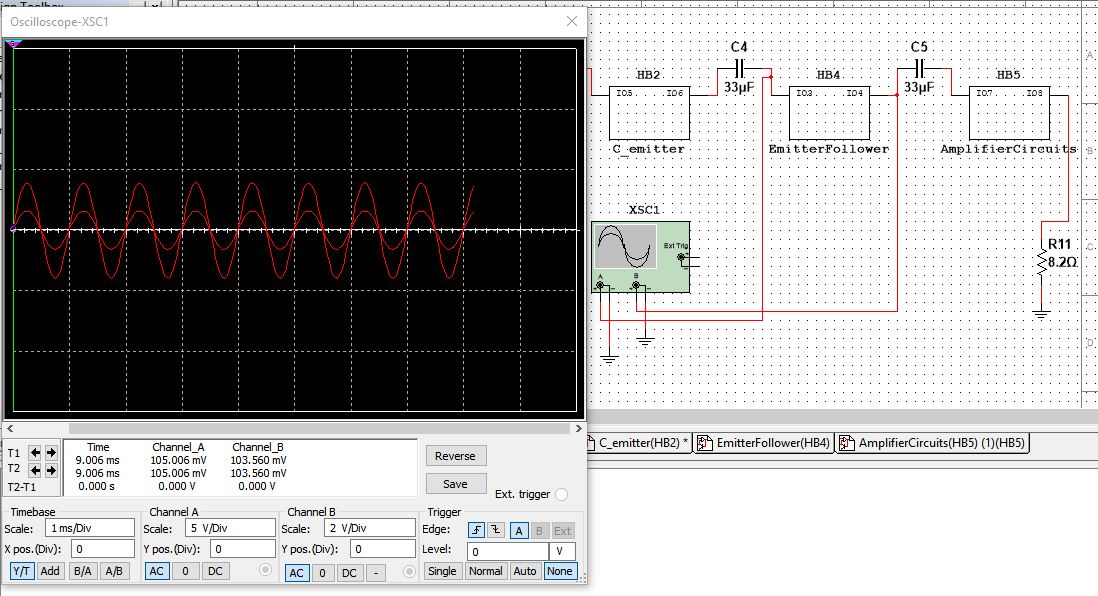
[picture p27: figure]

Şekil 4.4.2: Dördüncü Katman Olan İkinci Emetör Takipçisi Devresinin Kazanç Simülasyonu

Buna göre kazanç:

|A_V |=(103.560mV)/(105.006mV)≅0.98

Buradan ikinci emetör takipçisi devresinin %98 kazanç ile çalışmış olduğu gözlemlenmiş olunur. Bu değer aslında iyi bir değerdir. Çünkü en başta da belirtildiği gibi devre tasarımı yapılırken istenen 500 kazançtan biraz daha fazla kazanca göre yapıldı. Bunun sebeplerinde biri PCB üzerine gerçek hayatta devre elemanları monte edildiğinde PCB kazancının düşmesi riskini ortadan kaldırmak, bir diğeri de bazı katmanlarda düşen verimi avantaja dönüştürerek 500’den fazla olarak elde edilmiş olan kazancı 500’e maksimum ölçüde yakınsatabilmektir. İşte bu nedenle bu katman bu görevi yerine getirir ve kazanç hesabında iki common emetör devresinin çarpımı ile çarpılarak sonucu (tıpkı 2. ve 5. katmanında yapmış oldukları gibi) 500’e maksimum düzeyde yaklaştırır.

Emetör takipçisi kazancının 0.98 yani yaklaşık 1 olması beklenilen bir durumdur çünkü bu devrenin görevi “buffer” özelliği göstermek ve genel kazancı hiçbir şekilde değiştirmemektedir. Elde edilmiş olan bu kazançta zaten bu durumu doğrular niteliktedir.

  4.5. Power Amplifier (5. Katman)

Tasarlanmış olan devrenin en son katmanı olan yükseltici devresinde asıl amaç gelen voltaja uygun olarak akım çekilmesini ve böylece 5 watt güç çekebilmektir. Buna uygun olarak aşağıdaki görseldeki gibi bir yükseltici katı tasarlanmıştır:

Şekil 4.5.1: Tasarlanan Devrede Kullanılan Beşinci ve Sonuncu Katman Olan Güç Yükselticisi Devresi

Tasarlanmış olan bu yükseltici katmanının simülasyonu ve simülasyonda elde edilmiş olan değerlerine göre bulunan kazancının yine emetör takipçisi gibi 1 olması beklenir. Bu durum şu şekilde gösterilebilir:

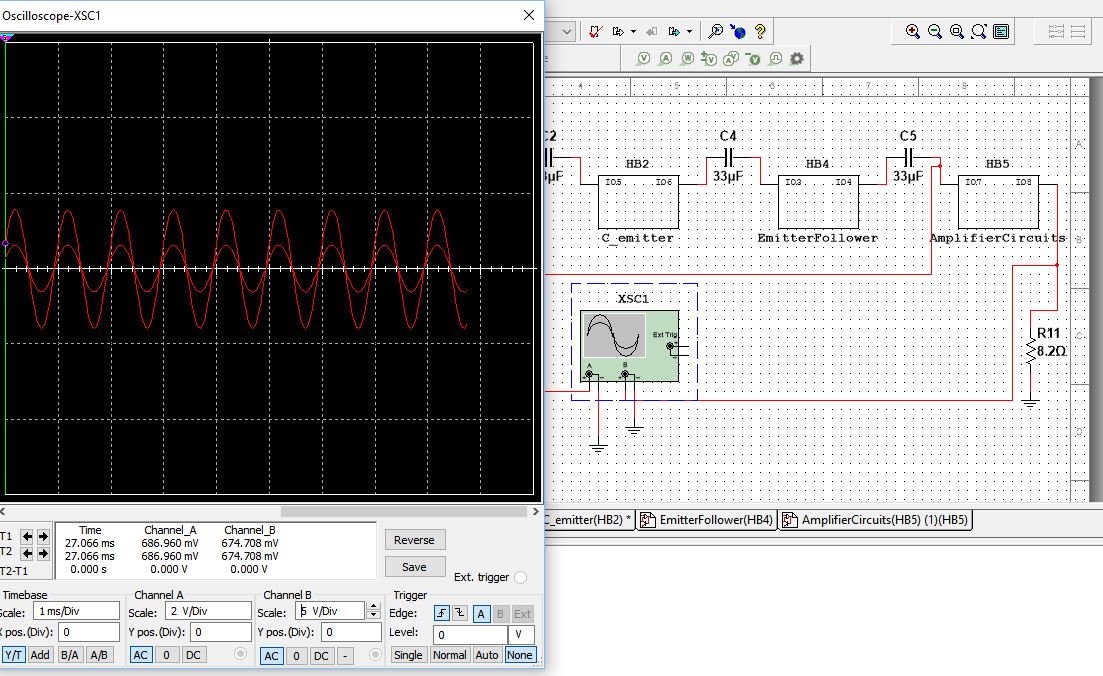
[picture p28: figure]

Şekil 4.5.2: Beşinci Katman Olan Güç Yükselticisi Devresinin Kazanç Simülasyonu

Buna göre kazanç:

|A_V |=(674.708mV)/(686.960mV)≅0.98

  4.6. Tüm Devre (5 Katmanlı Devre)

Tüm katmanlar ayrı ayrı simüle edildikten, bu katmanların birleştirilmesiyle elde edilmiş olan devrenin genel devre de yine Multisim programı kullanılarak simüle edilmiş ve beklenen kazanç değeri gözlemlenmeye çalışılmıştır. Tüm devrenin simülasyonun yapıldığı gösterim aşağıdaki Şekil 4.6.1 ve Şekil 4.6.2’deki gibidir:

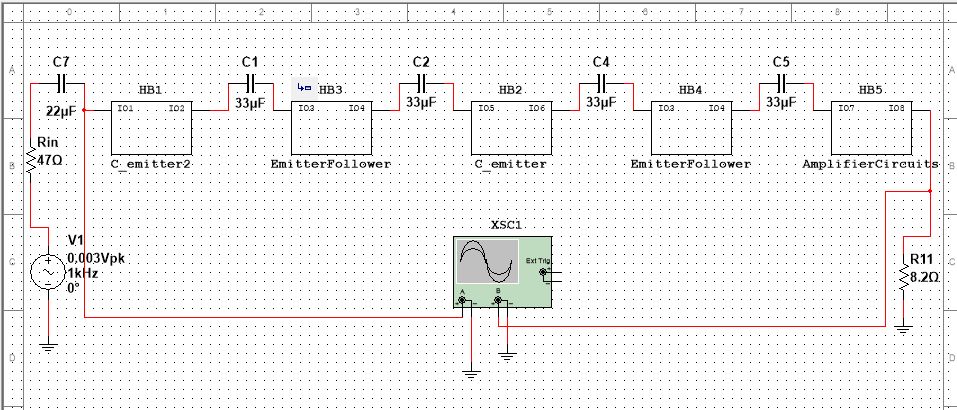
[picture p29: figure]

Şekil 4.6.1: Proje Boyunca Tasarlanmış Olan 5 Katlı Devre

Tüm bu devreden beklenen 500 kazanç, 5 watt güç çekme ve 20 Hz – 1 MHz arası frekans kesim noktalarıdır. Bütün bunları gösteren simülasyon sonuçları aşağıdaki gibidir:

i. Kazanç:

Simülasyon sonuçlarına göre çıkış voltajının giriş voltajına oranı kullanılarak aşağıdaki gibi kazanç bulunur:

|A_V |=(1.268V)/(2.425mV)≅520

Teorik olarak hesaplanmış olan kazanç değeri ile simülasyon sonucu elde edilen değer birbirine yakın olduğundan simülasyon başarılı olarak yapılmıştır. Bunun yanı sıra her bir devre katmanı kullanarak devrenin kazancı hesaplanacak olursa:

|A_V |=39.4*0.99*14*0.98*0.98=524

Bu kazanca bakılarak tüm devrenin simülasyonu sonucu elde edilen kazanç (520) ile her bir katın kazancının çarpımı ile elde edilmiş olan kazancın (524) hemen hemen eşit olduğu gözlemlenmektedir. Bu durumunda simülasyonun başarılı bir şekilde gerçekleşmiş olduğunun bir kanıtı olduğu ve beklenen sonucun doğru bir şekilde elde edilmiş olduğu söylenebilir. Bunun daha rahat gözlemlenmesi için aşağıdaki Şekil 4.6.2’deki gibi elde edilmiş olan simülasyon sonucuna bakılabilir:

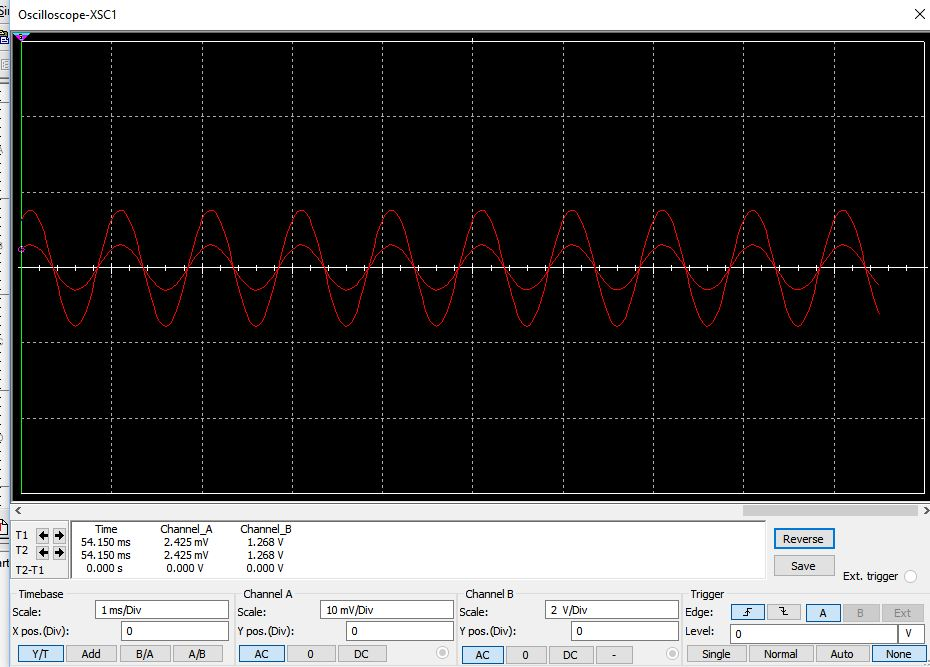
[picture p30: figure]

Şekil 4.6.2: Tasarlanmış Olan Tüm Devrenin Kazanç Simülasyonu

ii. 5W Güç:
iii. 20 Hz – 1 MHz:

Bu kesim frekansları elde edilirlerken bazen teorik olarak verilen kapasitör değerleri simülasyonda uygun olmadıklarından elle rastgele değiştirilerek aşağıdaki gibi genel devrenin frekans cevabı grafiği elde edilmiştir. Daha sonrasında aşağıdaki gibi cursor kullanılarak öncelikle tepe değere bakılmıştır. Y1 ve y2 değişkenleri tepe noktalarını vermektedir. Bunlara karşılık gelen x1 ve x2 değişkenleri ise bu y değerlerine karşılık gelen frekans değerlerini göstermektedir. Grafikteki tepe noktası değerlerinin, cursorların sağa veya sola kaydırılarak, 3 birim azaldıkları yer kesim frekanslarını vermektedir. Yani başta aşağıdaki gibi tepe değer her iki y değişkeni içinde 17k’dır.

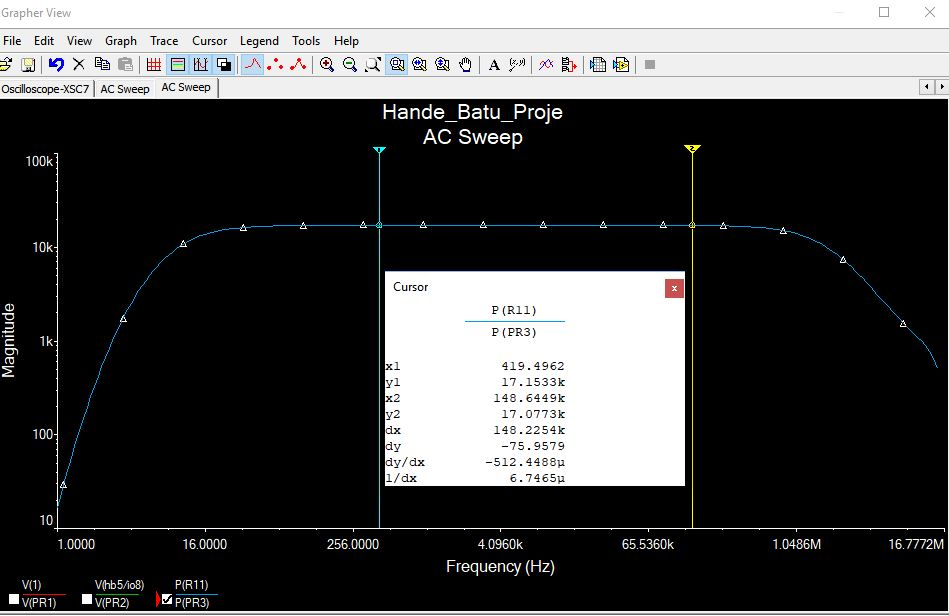
[picture p31: figure]

Şekil 4.6.3: Tasarlanmış Olan Tüm Devrenin Frekans Cevabı İçin Kullanılan Tepe Noktası Değerleri

Daha sonrasında y değerleri 3’er birim düşerek 14k’ya geldikleri x değişkenleri aşağıdaki görselde de olduğu gibi düşük kesim frekansı olarak 20Hz’i yüksek kesim frekansı olarakta 1MHz’i vermiştir. Yani simülasyon sonucu doğru elde edilmiştir.

Proje de +5 bonus puanı olarak istenilen 30 MHz’lik yüksek kesim frekansını elde etmek için fazlasıyla deneme yapıldı. Fakat sonrasında kullanılan transistör ve kapasitörlerin bu kesim frekansına kadar çıkarılabilecek özellikte olmadıkları ve maksimum 6 MHz’lik bir kesim frekansını sağlayabilecekleri anlaşıldı. Bu nedenle devre 1 MHz’de kesilmiş oldu.

Aşağıdaki görselde cursor ile ifade edilmiş olan x1 değişkeni düşük kesim frekansı olan 20 Hz’i x2 değişkeni ise yüksek kesim frekansı olan 1 MHz’i temsil etmektedir.

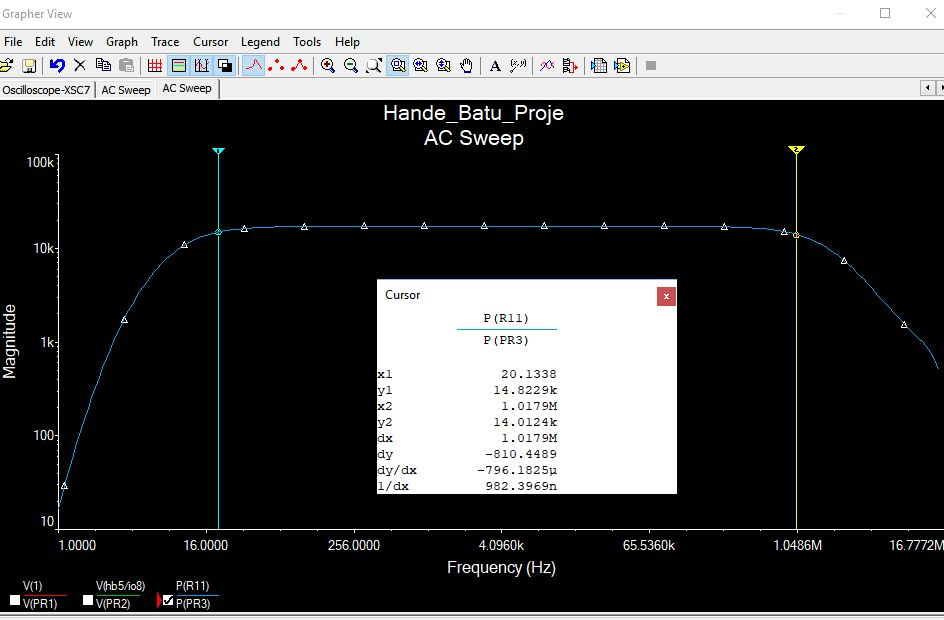
[picture p32: figure]

Şekil 4.6.4: Tasarlanmış Olan Tüm Devrenin Frekans Cevabını Gösteren Grafik

Tüm bu hesaplamalar ve tasarım sonucu Rapor 1’deki gibi bir devre başarım tablosu yapmak gerekirse:

Tablo 4.6.1: Devre Başarım Tablosu

| El Hesabı | Simlasyon Programı Sonuçları
Yüksek Eşik Frekansı | 1MHz | 1MHz
Düşük Eşik Frekansı | 20Hz | 20Hz
8 W Yük İle Gerilim Kazancı | 500 | Yaklaşık 500(520)
Güç Tüketimi | 5W RMS | 5W RMS
Giriş Direnci | 47 Ohm | 47 Ohm
Çıkış Direnci | 8 Ohm | 8.2 Ohm
Maksimum Çıkış Salınımı | 4 Volt | 3.90Volt

5. SONUÇLAR

Devre tasarımı ve analizleri tamamlandıktan sonrasında her bir devreyle ilgili sonuçlar genel olarak bu devrelerin altında açıklanmıştır. Fakat genel olarak proje yapım sürecindeki sonuçlar şu şekilde de özetlenebilirler:

1) Öncelikle 5 katmanda tasarlanmış olan tüm devreye bakılacak olursa 500 kazanç, 20 Hz – 1MHz aralığında, 8 Ω direnç değeri için 5W RMS güç çıkışı veren bir devre elde edilmiştir.
2) Başta 200 kazançlı ve 2W RMS güç çıkışı veren devre 3 katmanda tasarlanmaya çalışılmıştır. Fakat sonrasında bu durumun hem teorik hem de simülasyon kısmında ciddi zorluklara sebep olduğu anlaşılarak genel devre 5 katmana çıkarılmış ve 2 Common Emitter, 2 Emitter Follower ve 1 Power Amplifier devreleri kullanılmıştır. Sonrasında ise bonus puan olarak verilen aşamalara göre devre gerçeklenmiştir.
3) Bonus puan olarak verilecek olan 30 MHz’e göre hesaplamalar yapılmış ve devre buna göre de tasarlanmıştır. Fakat bu kesim frekansına bir türlü ulaşılamamıştır. Bunun nedeninin ise devre de kullanılmış olan transistör ve kapasitörlerden kaynaklandığı anlaşılmıştır. Çünkü böyle bir devrede kullanılabilecek bu devre elemanları maksimum 6 MHz’lik bir yüksek kesim frekansı verebilmektedirler.
4) Devre teorik hesaplamaları ile simülasyon program sonuçları karşılaştırılmıştır ve bunun sonucunda elde edilmiş olan veriler birbirlerine oldukça yakındırlar. Bu nedenle devrenin hem teorik hem de bilgisayarla analizi doğru yapılmıştır.
5) Bazen teorik olarak doğru gelen değerler simülasyon üzerinde devreyi satürasyona sokmuşlardır. Bu durumda rastgele değerler değiştirilerek devre satürasyondan çıkarılmıştır. Böylece amacına uygun hale getirilmiştir. Sonrasında yeni değerlere göre teorik hesaplamalar tekrarlanmışlardır.
6) Simülasyon programı olarak pek çok program (LTSpice, Pspice ve Eagle) kullanılmıştır, fakat en verimli sonuçlar ve başarılı gözlemlerin Multisim programı ile elde edildiği gözlemlenmiştir.
7) Devre tasarımı ve analizi yapıldıktan sonrasında PCB tasarlama kısmında da yine değişik programlar (Ultiboard14.2, Eagle) denenmiştir. Fakat Altium programının çizim ve ayarlamalar açısından daha rahat kullanıldığı anlaşıldığından PCB tasarımı bu program ile gerçeklenmiştir.
8) Devre tasarımı aşamasında başta, teorik değerler bulmaya çalışılıp sonra simüle etmek planlamıştır. Fakat bu yöntem ile denklemleri çözmenin ciddi bir zaman kaybına neden olduğu bu yüzden de zamanın verimli kullanılamadığı anlaşılmıştır. Buna çözüm olarak öncelikle devreler Multisimde ayrı ayrı çizilmiş. Temel teorik hesaplamaları yapılmış, buna göre simüle edilerek proje amacına uygun tasarlanmıştır. Sonrasında ise piyasa da bulunan ve satılan gerçekçi değerler internetten araştırılarak devre bunlara göre tekrar tasarlanmıştır.
9) Tüm bu aşamalar sonucunda devre başarılı bir şekilde amacına uygun olarak gerçeklenmiştir.
6. BOM LİSTESİ

Devre tasarlandıktan sonra PCB lehimleme kısmına geçilebilmesi için devrenin değerlerinin gerçekte var olan malzeme değerlerine göre baştan ayarlanması ve tasarımının da buna uygun olarak kontrol edilmesi sağlanmıştır. Bu durumda kullanılan malzemeleri gösteren BOM Listesi aşağıdaki görsel olarak gösterilen Excell tablosundaki gibi hazırlanmıştır:

Tablo 6.1: BOM Listesi

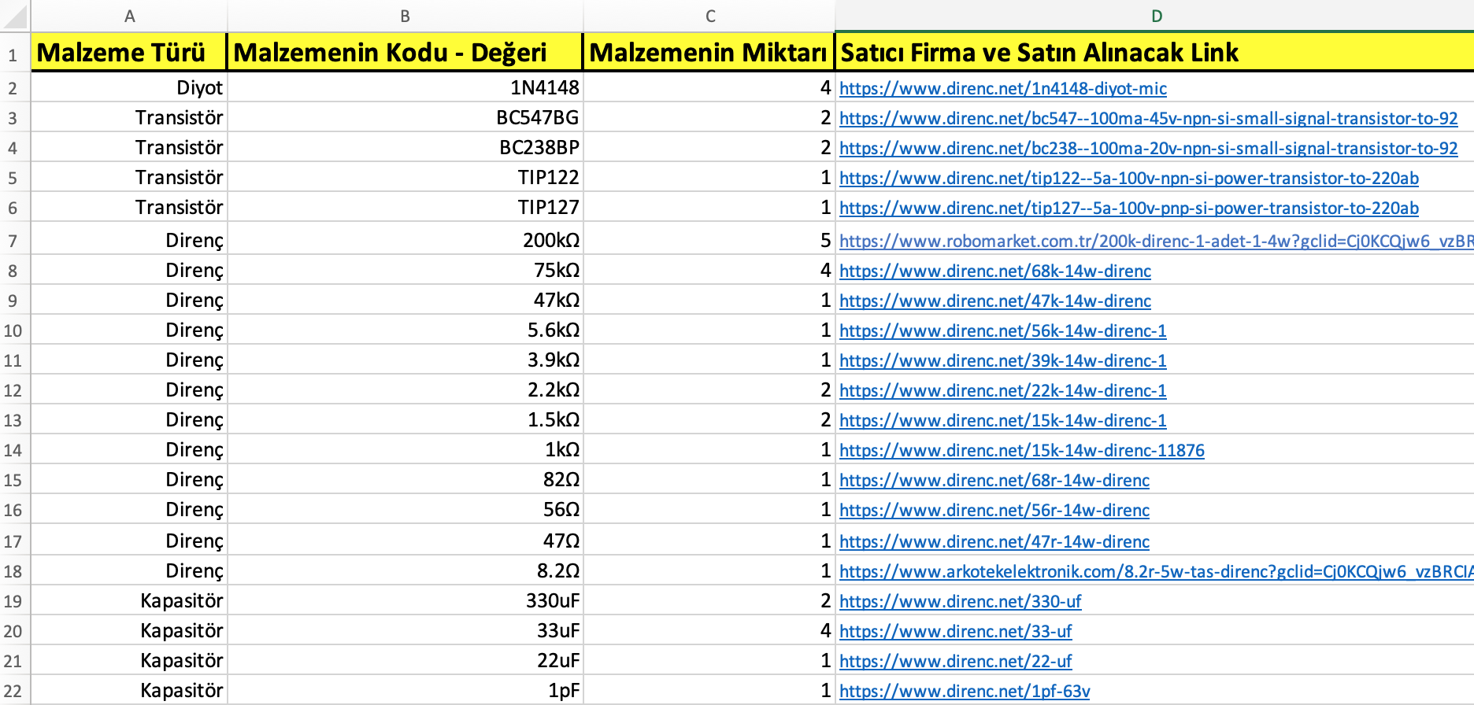
[picture p33: figure]

7. KAYNAKÇA

[1] https://www.desmos.com/calculator/bbodbfnv3v

[2] https://www.direnc.net/

[3] http://www.ee.nmt.edu/~anders/courses/ee321f13/hw09.pdf

[4]https://www.slideshare.net/ahmadFiaz/eeg381-electronics-iii-chapter-2-feedback-amplifiers
