handeyildirim/Analog-PCB-and-Schematic-Designing-Project/BOM LİSTESİ.xlsx

Malzeme Türü | Malzemenin Kodu - Değeri | Malzemenin Miktarı | Satıcı Firma ve Satın Alınacak Link
Diyot | 1N4148 | 4 | https://www.direnc.net/1n4148-diyot-mic
Transistör | BC547BG | 2 | https://www.direnc.net/bc547--100ma-45v-npn-si-small-signal-transistor-to-92
Transistör | BC238BP | 2 | https://www.direnc.net/bc238--100ma-20v-npn-si-small-signal-transistor-to-92
Transistör | TIP122 | 1 | https://www.direnc.net/tip122--5a-100v-npn-si-power-transistor-to-220ab
Transistör | TIP127 | 1 | https://www.direnc.net/tip127--5a-100v-pnp-si-power-transistor-to-220ab
Direnç | 200kΩ | 5 | https://www.robomarket.com.tr/200k-direnc-1-adet-1-4w
Direnç | 75kΩ | 4 | https://www.direnc.net/68k-14w-direnc
Direnç | 47kΩ | 1 | https://www.direnc.net/47k-14w-direnc
Direnç | 5.6kΩ | 1 | https://www.direnc.net/56k-14w-direnc-1
Direnç | 3.9kΩ |  | https://www.direnc.net/39k-14w-direnc-1
Direnç | 2.2kΩ | 2 | https://www.direnc.net/22k-14w-direnc-1
Direnç | 1.5kΩ | 2 | https://www.direnc.net/15k-14w-direnc-1
Direnç | 1kΩ | 1 | https://www.direnc.net/15k-14w-direnc-11876
Direnç | 82Ω | 1 | https://www.direnc.net/68r-14w-direnc
Direnç | 56Ω | 1 | https://www.direnc.net/56r-14w-direnc
Direnç | 47Ω | 1 | https://www.direnc.net/47r-14w-direnc
Direnç | 8.2Ω | 1 | https://www.arkotekelektronik.com/8.2r-5w-tas-direnc
Kapasitör | 470uF | 1 | https://www.direnc.net/470-uf
Kapasitör | 33uF | 4 | https://www.direnc.net/33-uf
Kapasitör | 22uF | 1 | https://www.direnc.net/22-uf
Kapasitör | 1pF | 1 | https://www.direnc.net/1pf-63v
Kapasitör | 220uF | 1 | https://www.direnc.net/220-uf
