handeyildirim/Analog-PCB-and-Schematic-Designing-Project/(list of files, drawings)

Other design files:
AnalogProje.PrjPcb
CommonEmitter.ms14
DevreHande.ms14
EmitterFollower.ms14
HandeBatuProje.SchDoc
